ebertmx/HUEBERT_MK1/documents/HUEBERT_Design_Proccess_presentation.pdf

# HUEBERT

### A REMOTE OPERATED ROBOT ARM

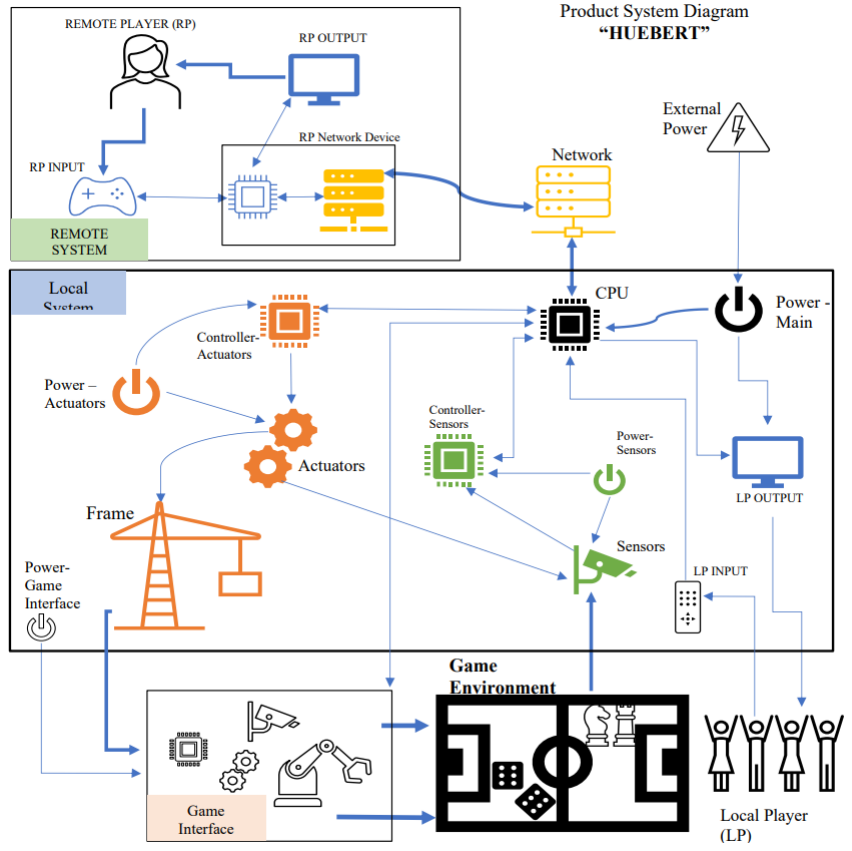
[picture p3: figure]

## System Diagram

## Design Diagram

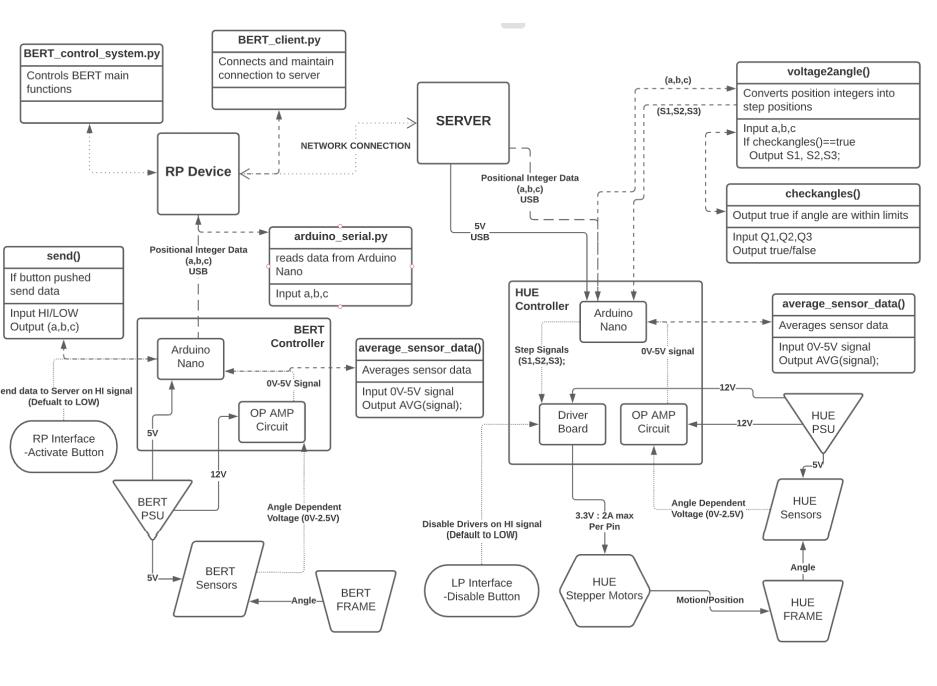
[picture p4: page 3]

## Use Case Diagram

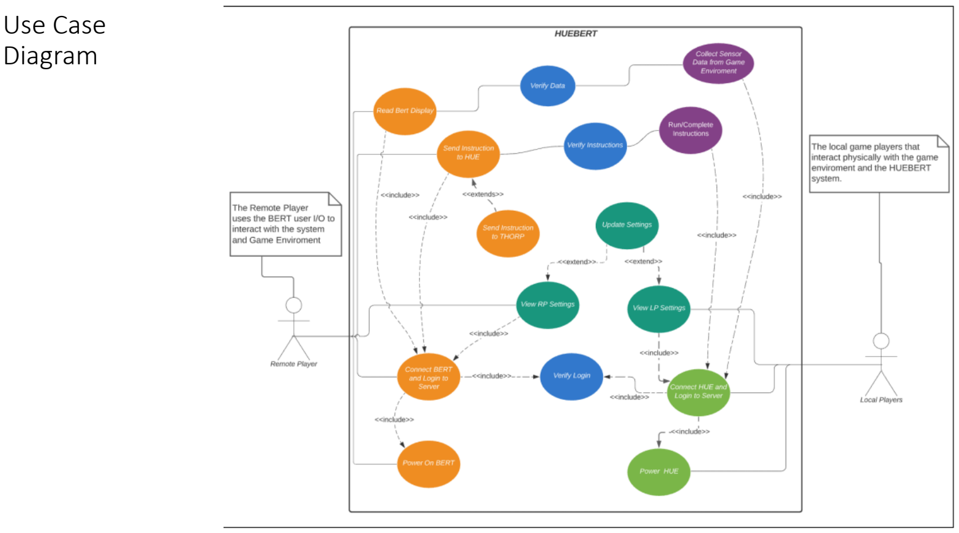
[picture p5: page 4]

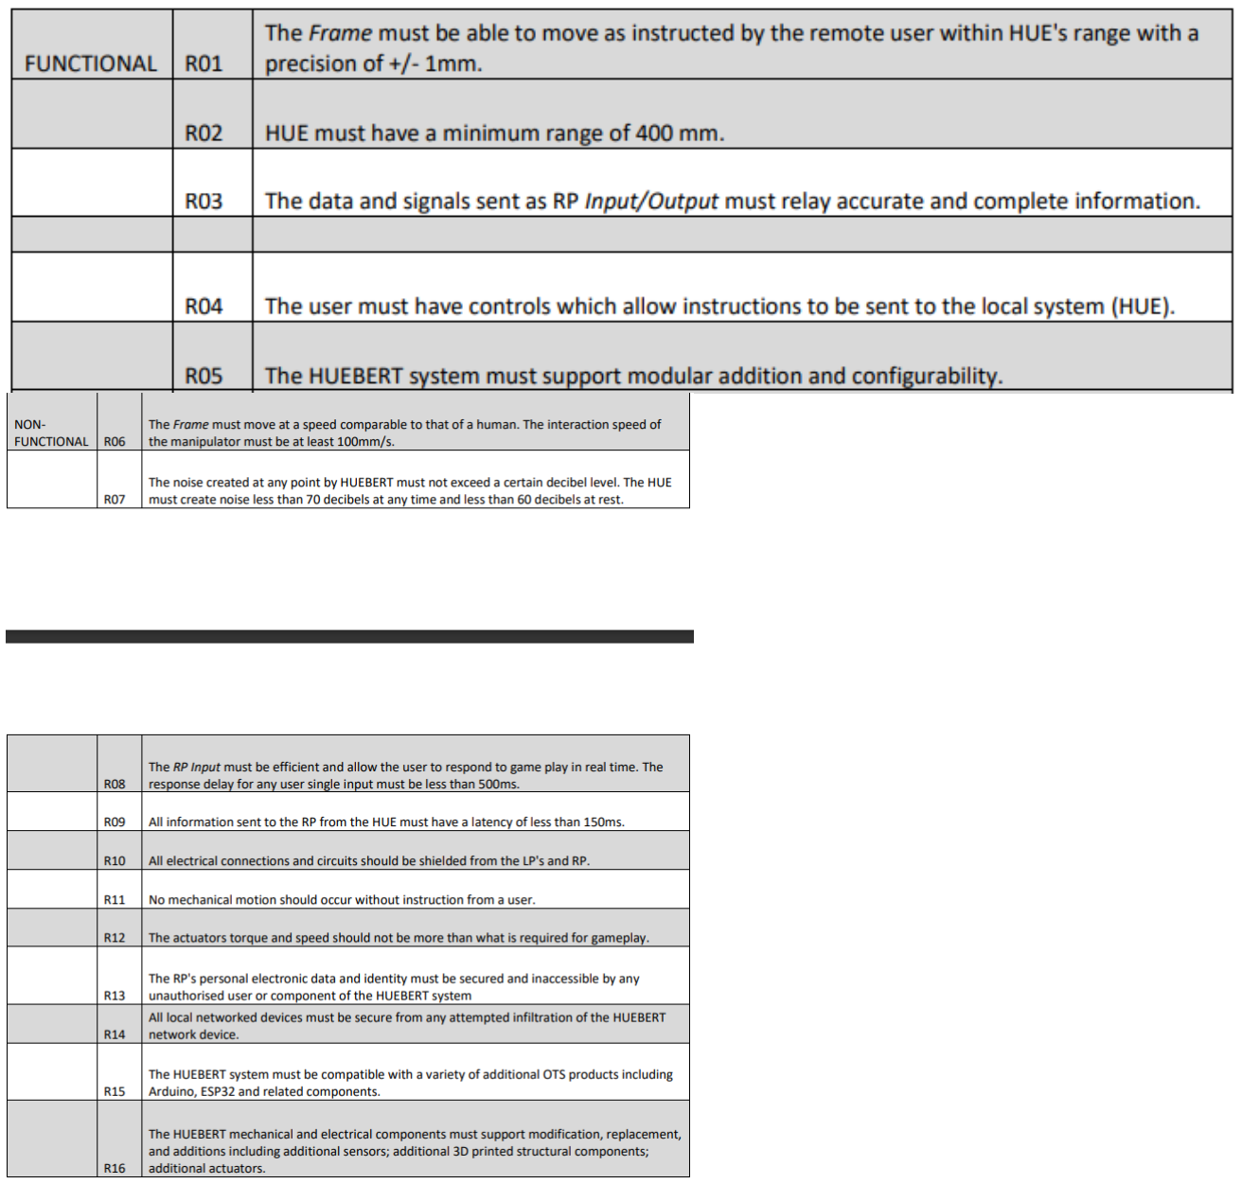
[picture p6: figure]

## Requirements

## User Stories

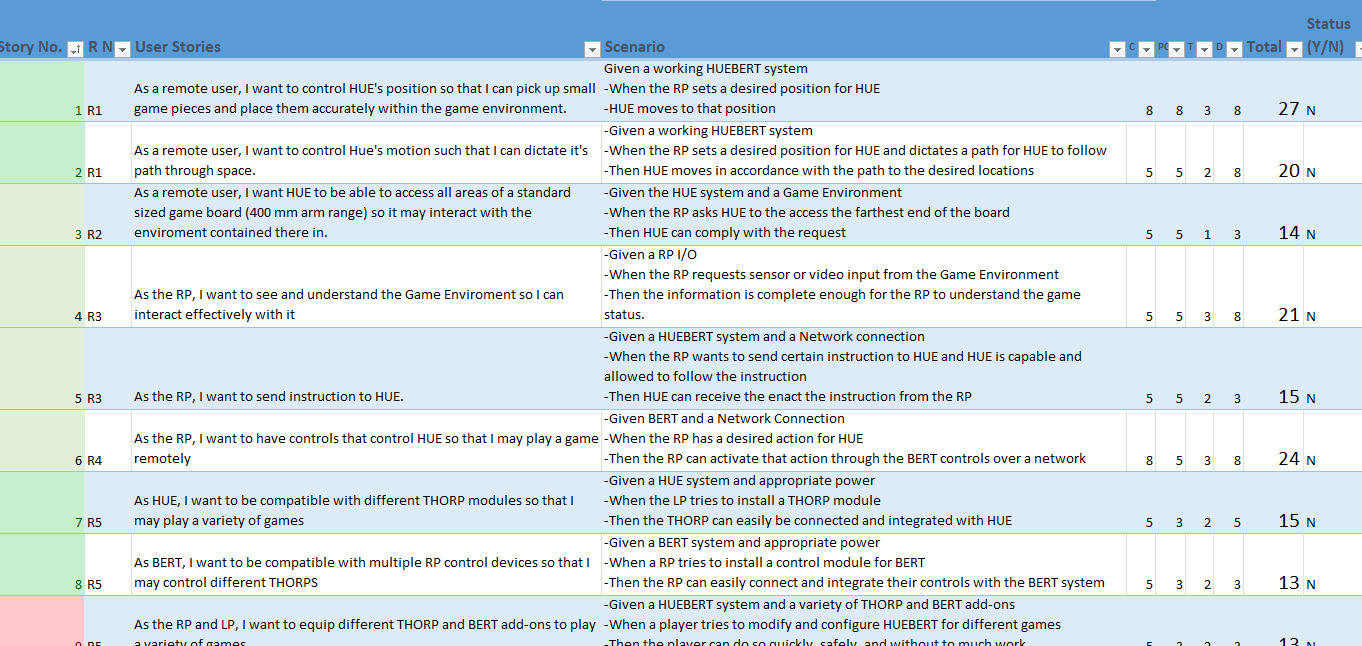
[picture p7: page 6]

# HUEBERT DESIGN/BUILD PROCESS

What actually happened.

### Could have been better/ more by the book

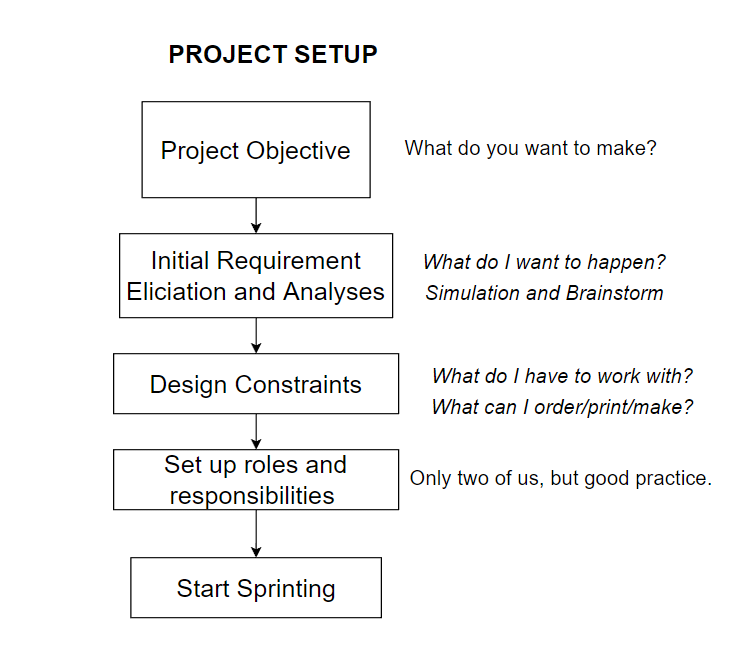
[picture p8: figure]
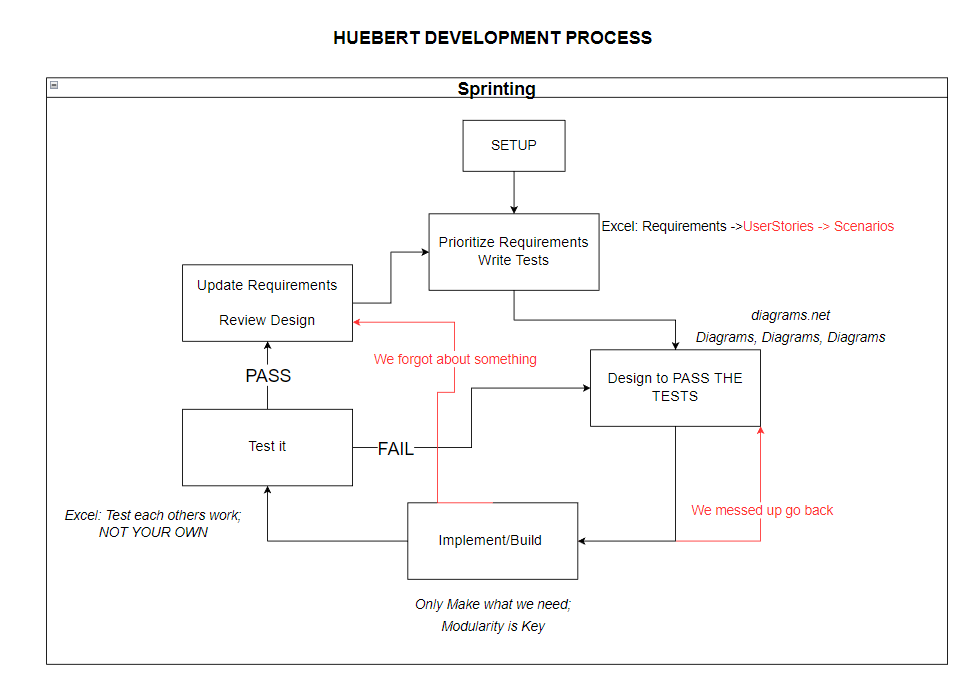
[picture p9: page 9]

# Diagrams

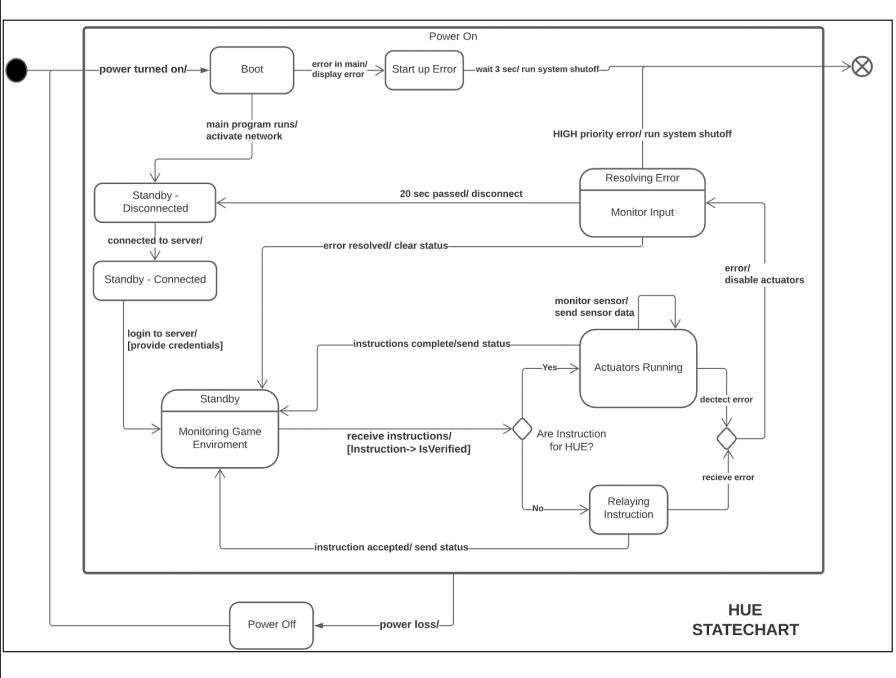
[picture p10: page 10]

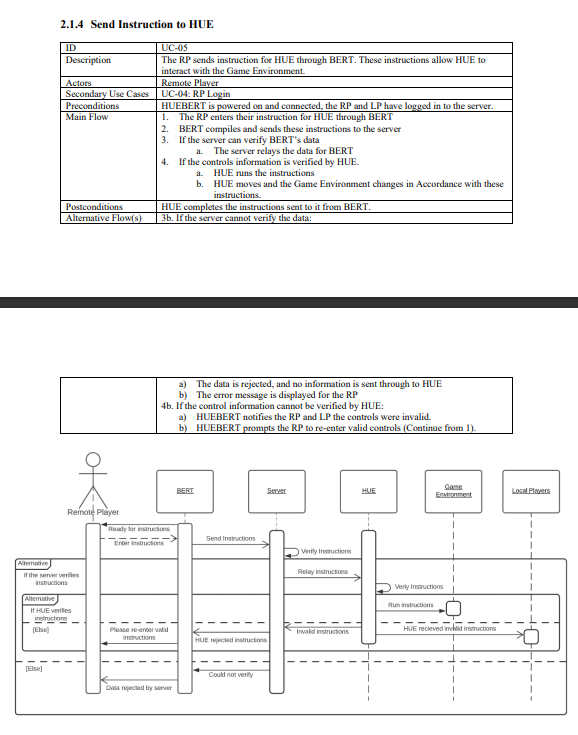
[picture p11: figure]

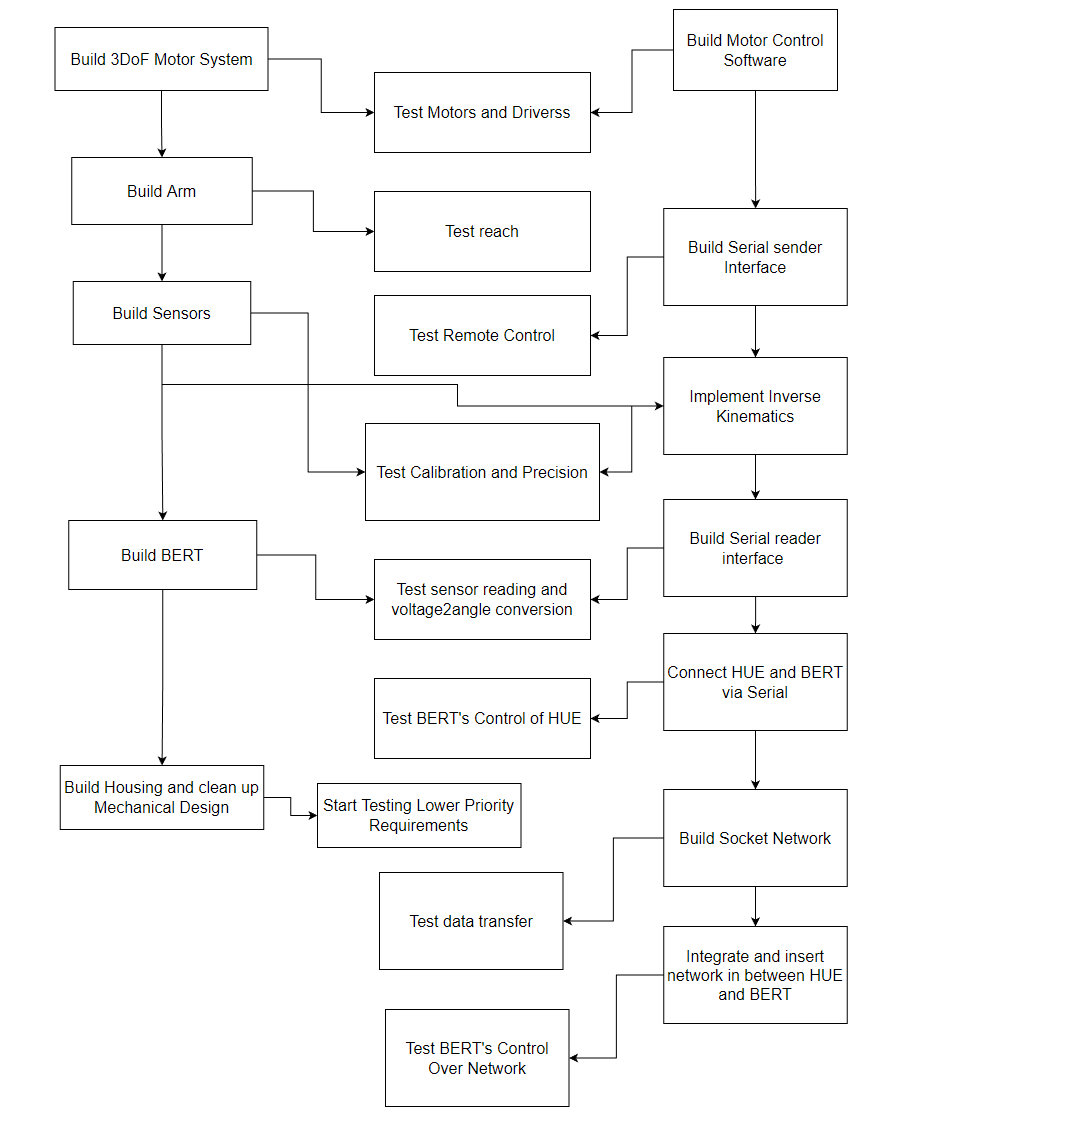
[picture p12: figure]

## Summary Timeline

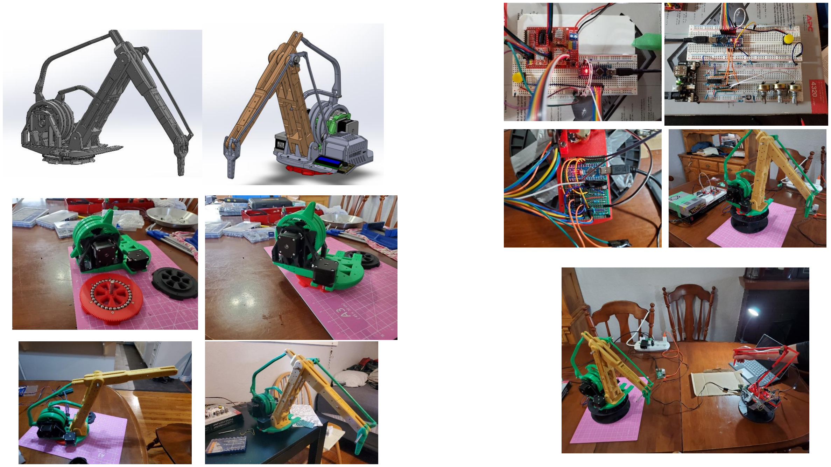
[picture p13: page 13]

# Recommendations

### What we did right/wrong

# What worked well for us

- Test Driven Development: Always had a ‘working’ product; Less ‘extra’ work
- Constant Hardware-Software Integration: When hardware ready, software was tested on it
- Diagrams: Most valuable design step (for me at least): Made building like working from an instruction booklet
- Agile: We found mistakes or requirement problems all the time; Quick meeting-> change excel sheet -> update diagram -> Good to go
- Maximize Documentation effectiveness: We used 2 documents: Requirements/Testing Spread Sheet, Diagram Folder; Easy to keep up to date without spending tons of time on it. Everything else made when needed.
- MODULARIZE: This made things so easy to change
- Do it EARLY: Always busy at the end of the semester

# What we should have done better

- Make requirements/tasks smaller
- Always more to each step than we realized
- Only two of us
- Make more specific requirements
- Take only a couple tasks each sprint
- Hit the ‘Review’ portion of the design more often but make it shorter.
- User Stories
- We didn’t use these enough; ran into issues (ie. Button hold)
- Research:
- Ran into limitations with certain components (ie. Nano processing speed for inverse kinematics)
- Prioritize Requirements/Backlog Better:
- Some requirements are dependent on other requirements, fit this into the prioritization process. (We had to break script because we failed to account for this).
- Don’t get attached to a design: I tried to force a bad solution which ended up wasting time. (ie. Use of raspberry pi; Should have bought an ethernet shield for Arduino instead.)

# Effective Tools We used

## - Diagrams.net: Easy, integrates with github and google drive - Shared Excel/Sheets: for requirements - SolidWorks - KiCad

- Arduino for simple embedded stuff. Fast because of IDE, peripherals,

## and documentation. Big learning curve for ESP and STM chips (Tried

at start but took too long).
