ebertmx/HUEBERT_MK1/(commit log)

2022-09-13 Added Local Implementation
    Updated UI and added functions to convert potentiometer voltage to relative angle of BERT
2022-09-14 Bug fixes for Matlab UI
    [BERT_embedded_controller_local_connection.ino, HUEBERT_embedded_contoller.ino]
